oturaz/Arduino-Hexapod-Project/video footage of robot in action.md

# Arduino-Hexapod-Project-2016

https://youtu.be/Dq1_J8lBc6A
